SaberPhung/LM35_PCBs_Design/10-11-Design-Digital-System.xlsx

Sheet: Analog Processing
Ulm35(mV) | Uout | Temperature
-284.3 | 2.91 | -30
-240 | 2.7
-207 | 2.55
-147 | 2.24
-106.7 | 2.04
-47.5 | 1.74
8.8 | 1.46 | 0
42 | 1.29
98.1 | 1.02
147.2 | 0.77
203.1 | 0.48
241.1 | 0.29 | 24
295 | 0.02

Sheet: Tranmitter
Ulm35(mV) | Iout (ma)
-291.5 | 19.76
-242.5 | 18.09
-215 | 17.16
-167.2 | 15.57
-82.1 | 12.75
-50 | 11.7
9.5 | 9.72
64.3 | 7.91
92.2 | 7.01
155.3 | 4.92
204.2 | 3.38
265 | 1.31
300.9 | 0
