SaberPhung/LM35_PCBs_Design/(list of files, drawings)

Other design files:
block4.pcb
test2.pcb
